AakaFosfor/MJOY16-CN_old/Pictures/use.JPG

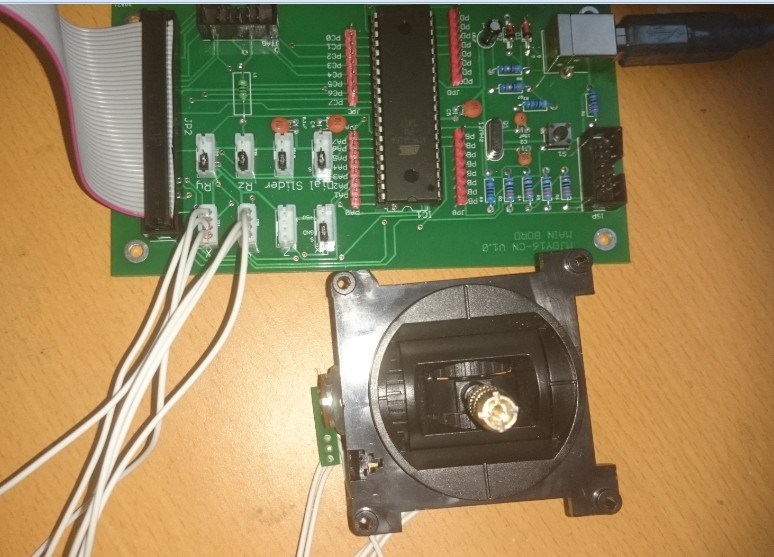
Pictures/use.JPG
