AakaFosfor/MJOY16-CN_old/Pictures/use2.JPG

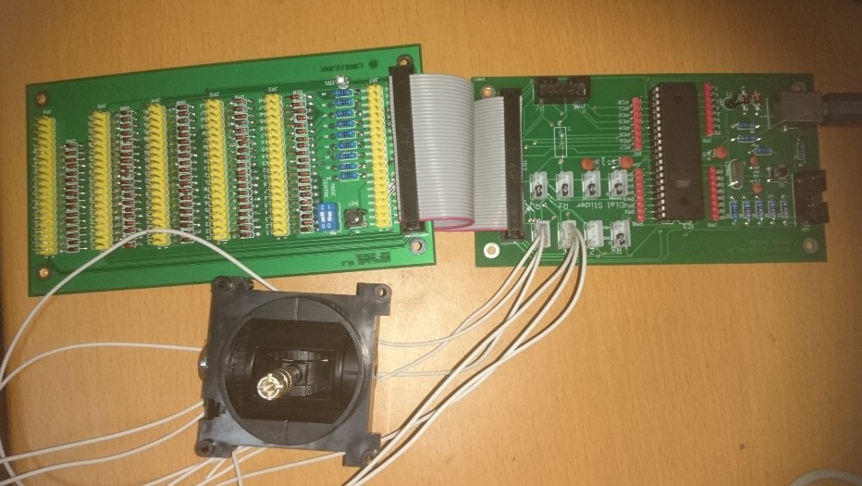
Pictures/use2.JPG
