AakaFosfor/MJOY16-CN_old/Documents/Fuse_Setting.JPG

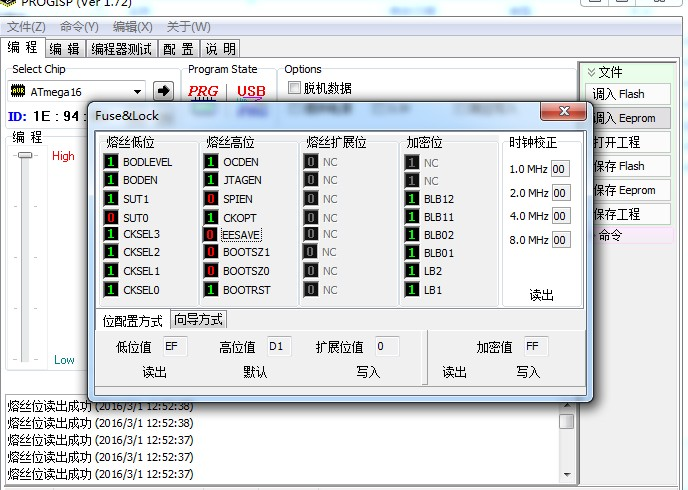
Documents/Fuse_Setting.JPG
