AakaFosfor/MJOY16-CN_old/Pictures/dubang.JPG

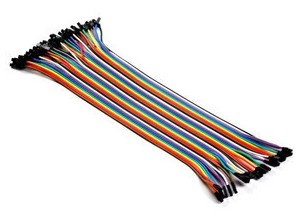
Pictures/dubang.JPG
