AakaFosfor/MJOY16-CN_old/Pictures/ide.JPG

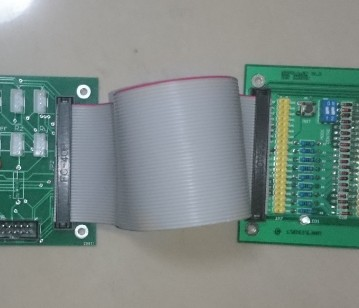
Pictures/ide.JPG
