AakaFosfor/MJOY16-CN_old/Pictures/jumper.used.JPG

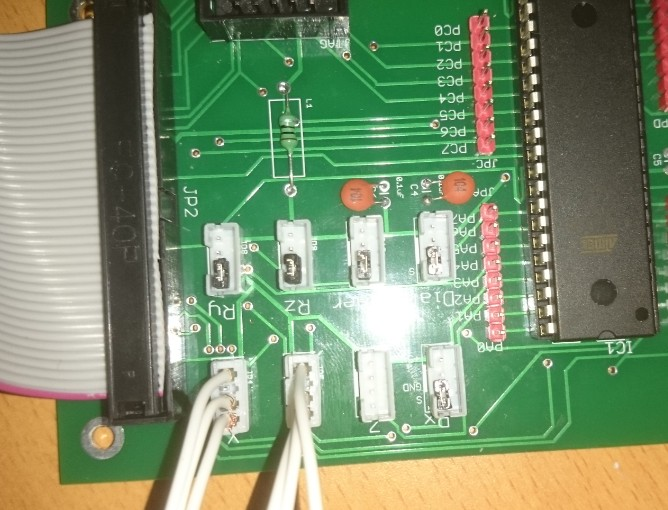
Pictures/jumper.used.JPG
