AakaFosfor/MJOY16-CN_old/Pictures/key.JPG

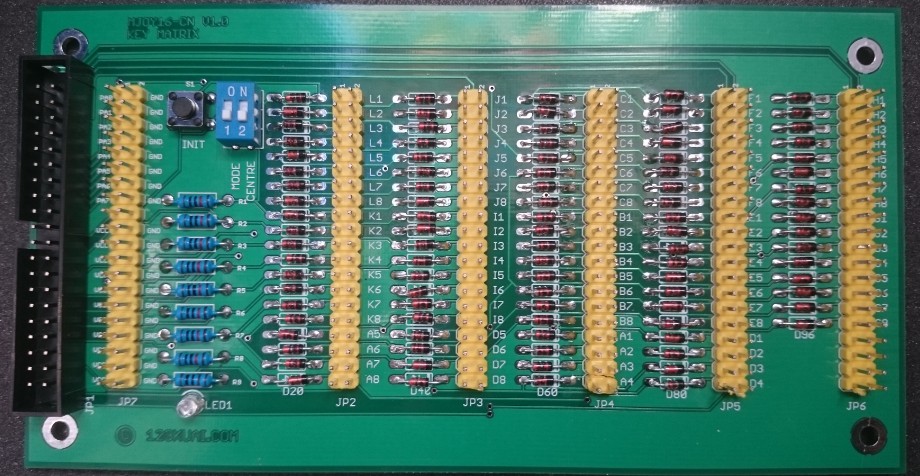
Pictures/key.JPG
