AakaFosfor/MJOY16-CN_old/Pictures/mainboard.jpg

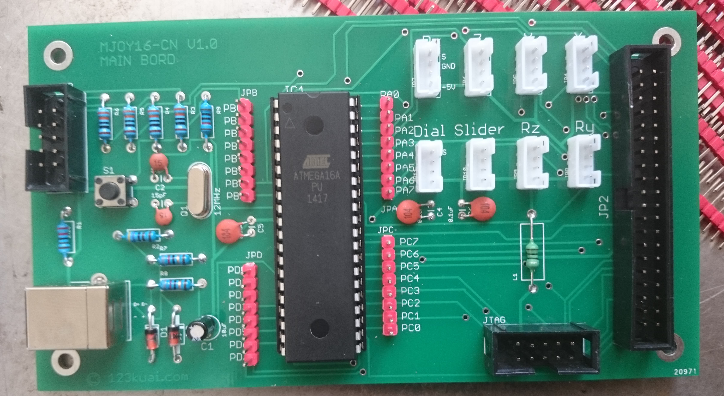
Pictures/mainboard.jpg
