AakaFosfor/MJOY16-CN_old/Pictures/pc.JPG

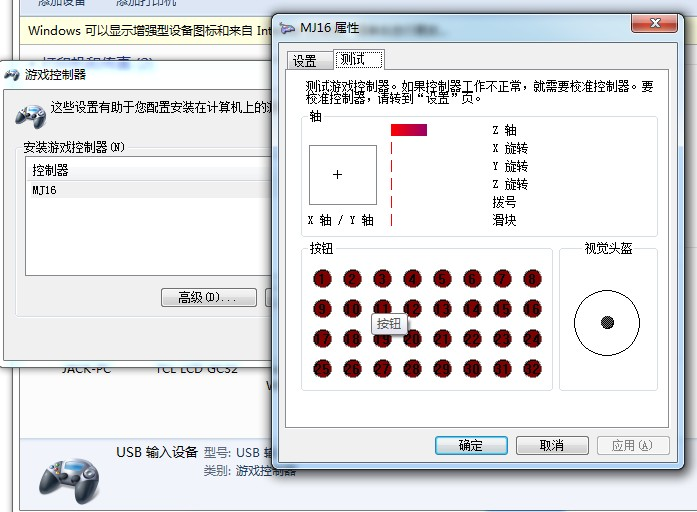
Pictures/pc.JPG
