AakaFosfor/MJOY16-CN_old/Pictures/usb.line.JPG

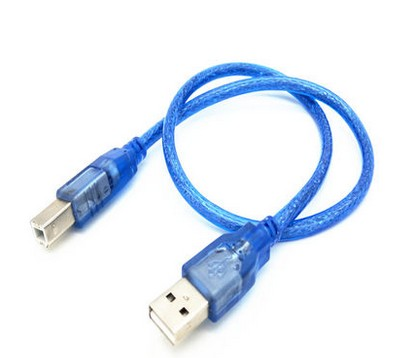
Pictures/usb.line.JPG
