AakaFosfor/MJOY16-CN_old/Schema/key_matrix.png

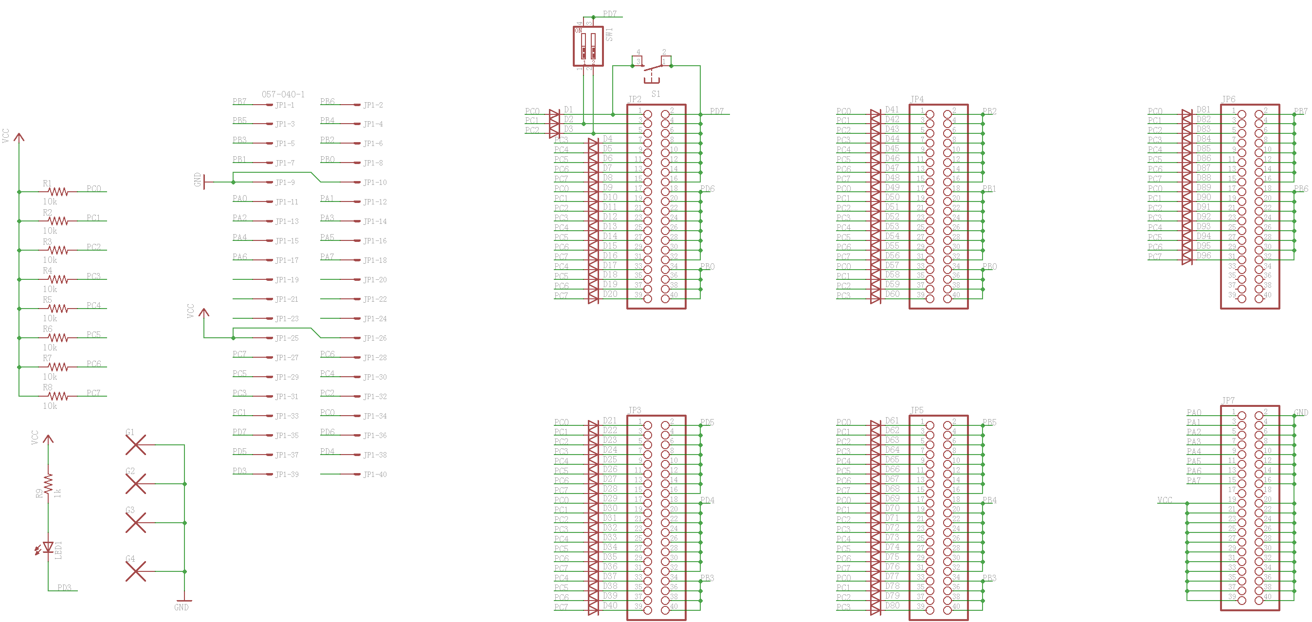
Schema/key_matrix.png
