AakaFosfor/MJOY16-CN_old/Schema/main_board.png

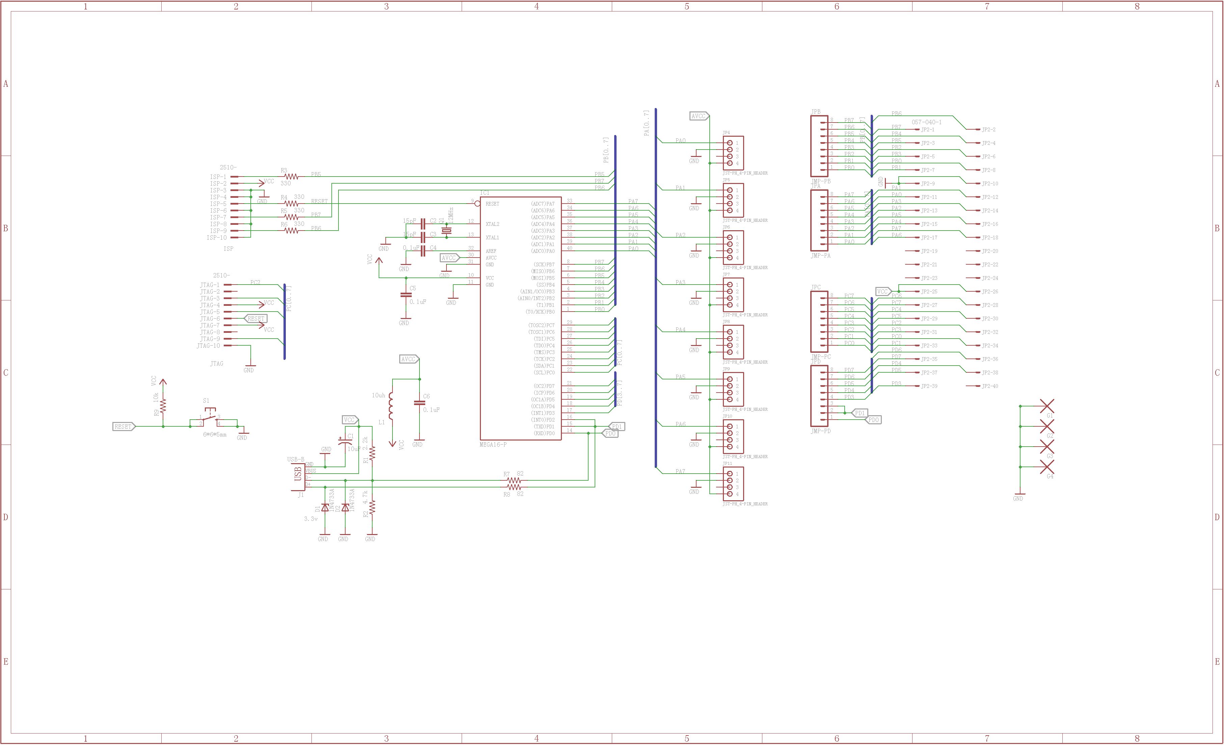
Schema/main_board.png
