AakaFosfor/MJOY16-CN_old/Documents/Key_Matrix_Schema_v1.pdf

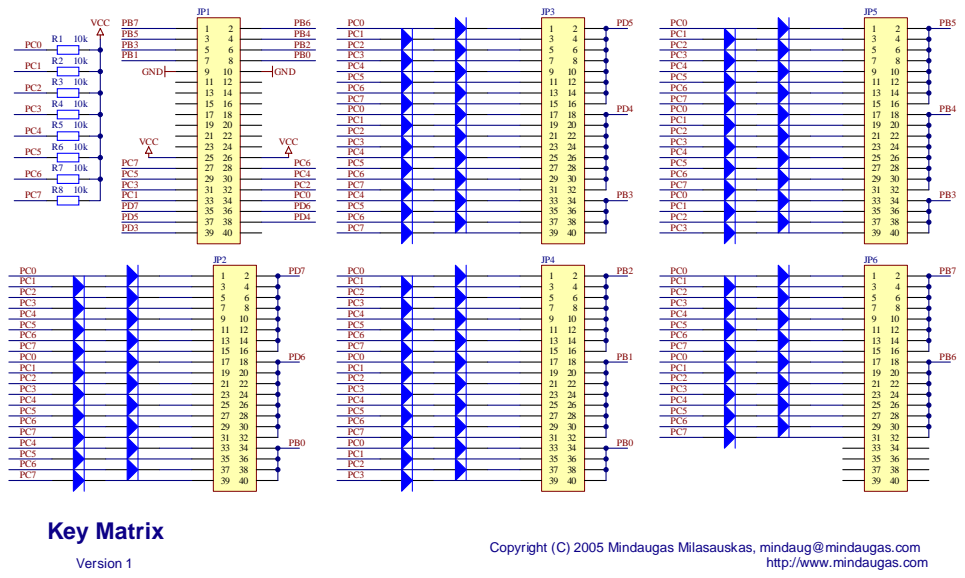
[picture p28: page 1]

Copyright (C) 2005 Mindaugas Milasauskas, mindaug@mindaugas.com

http://www.mindaugas.com

# Key Matrix version 1 Parts List

Description | Designator | Quantity | Value
High Conductance Fast Diode1N4148 | D1-D96 | 96
20x2 Header and Connector, 40-Pin, Dual row | JP1-JP6 | 6
Resistor | R1-R8 | 8 | 10k

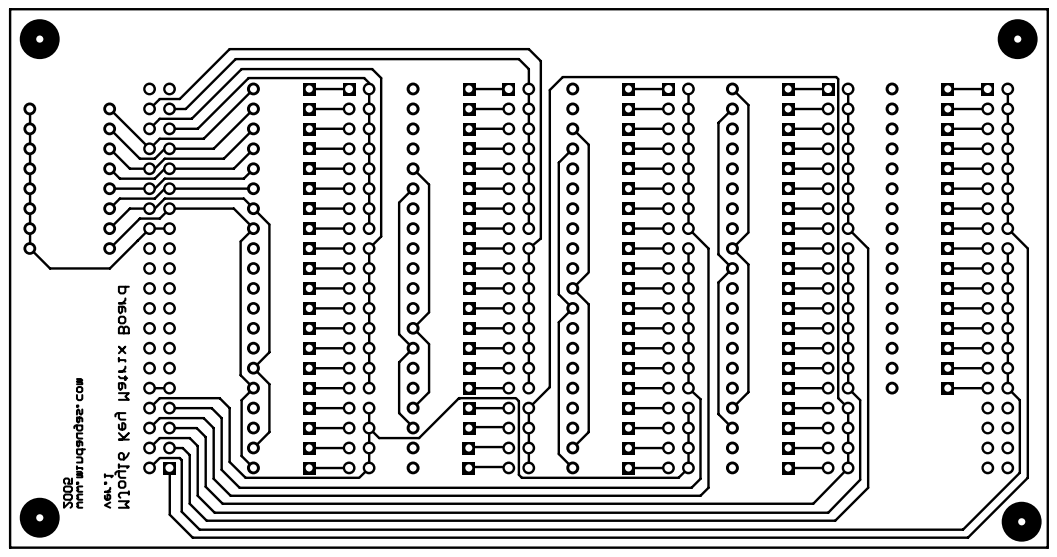
[picture p29: page 3]

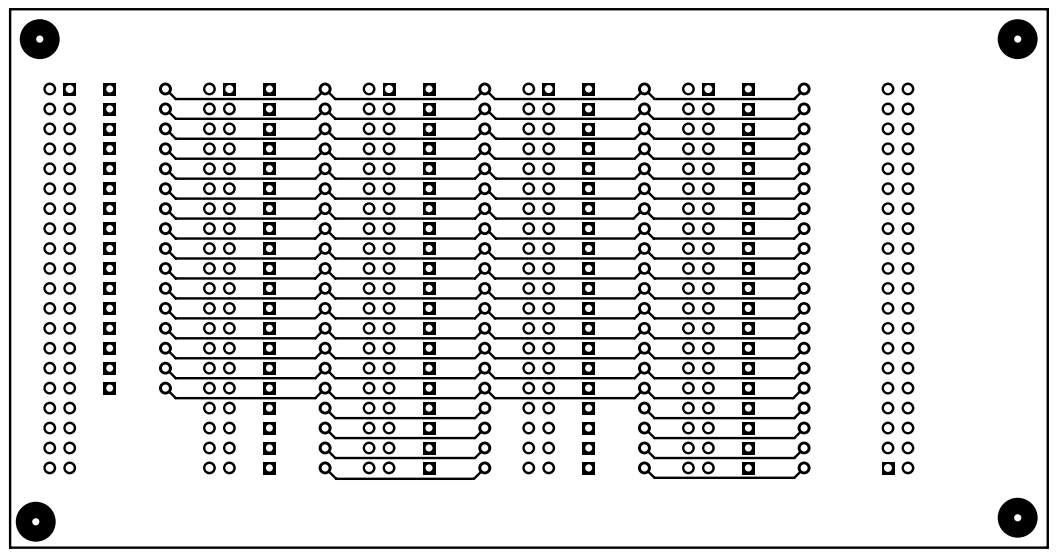
[picture p30: page 4]

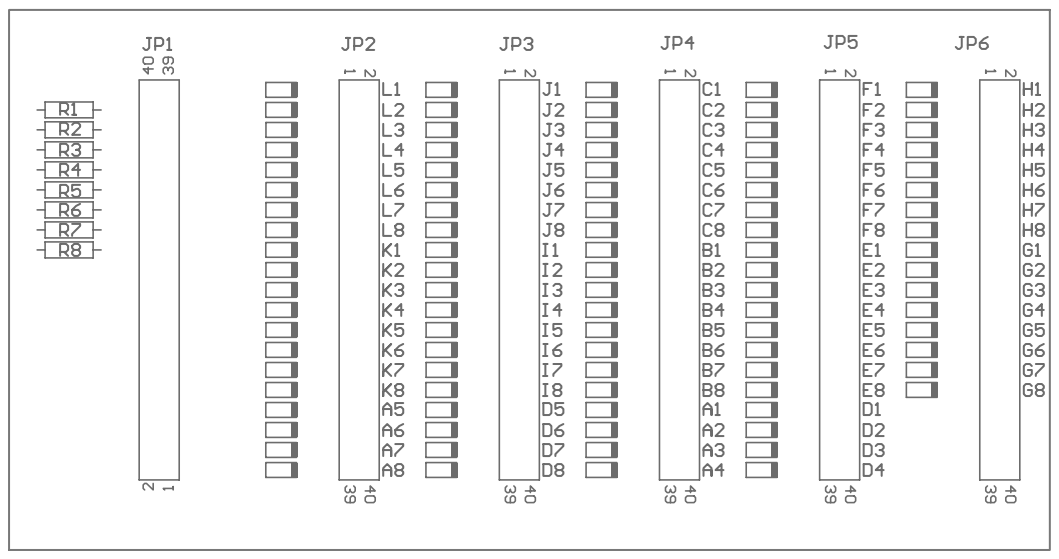
[picture p31: page 5]
