AakaFosfor/MJOY16-CN_old/(commit log)

2016-03-02 固件上传
    上传原版固件
2016-03-02 说明修改
2016-03-02 添加documents手册文件夹
    手册 熔丝位设置 电路图
2016-03-02 添加Mjoy按键映射软件
2016-03-02 添加Picture目录 应用照片
2016-03-02 添加主板和按键矩阵板电路图
2016-03-02 添加源代码，测试基本USB控制信息响应及板载LED
    集成V-USB库
2016-03-02 图片文件名
